cygnomatic/armor-plate/Program/README.md

# armor-plate

## 主要代码
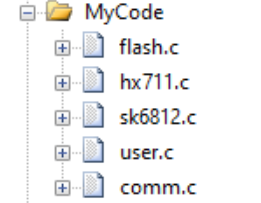
[picture p5: Program/image/1.png]
tree
  
flash.c flash存储器  
hx711.c A/D转换芯片，测量应变片形变  
sk6812.c 装甲板灯驱动  
user.c 装甲板颜色切换、设置id功能实现  
comm.c 装甲板间通信、调试串口通信
