cygnomatic/armor-plate/(list of files, drawings)

Other design files:
PCB/Armor_Plate.SchDoc
