cygnomatic/armor-plate/Program/armor_plate_v1.4/armor_plate_v1.4.ioc

Mcu.UserName=STM32F103C8Tx
PA10.Signal=USART1_RX
PA11.Signal=CAN_RX
PA12.Signal=CAN_TX
PA13.Signal=SYS_JTMS-SWDIO
PA14.Signal=SYS_JTCK-SWCLK
PA15.Signal=GPIO_Input
PA2.Signal=GPIO_Input
PA3.Signal=GPIO_Output
PA4.Signal=GPIO_Input
PA5.Signal=GPIO_Output
PA8.GPIO_Label=LED
PA8.Signal=GPIO_Output
PA9.Signal=USART1_TX
PB1.Signal=S_TIM3_CH4
PB10.Signal=USART3_TX
PB11.Signal=USART3_RX
PB3.Signal=GPIO_Output
PB4.Signal=GPIO_Input
PB5.Signal=GPIO_Output
PB6.Signal=S_TIM4_CH1
PD0-OSC_IN.Signal=RCC_OSC_IN
PD1-OSC_OUT.Signal=RCC_OSC_OUT
